gom9000/diode-tester/resources/ltspice-plot-1mA-thermal-drift.png

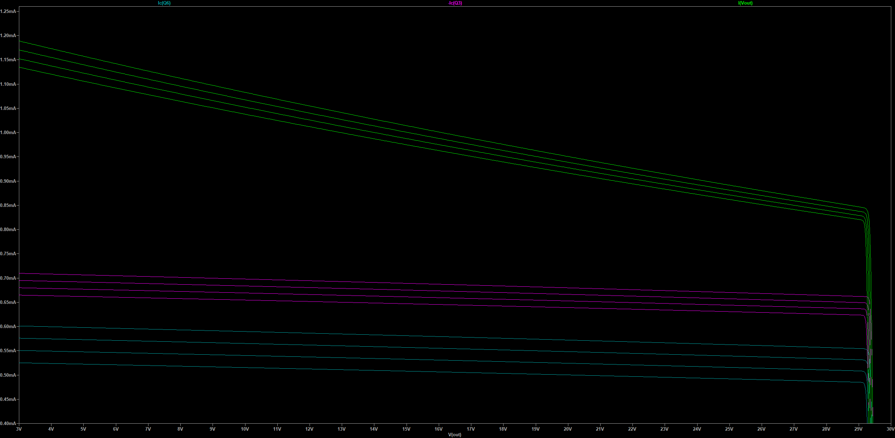
resources/ltspice-plot-1mA-thermal-drift.png
