gom9000/diode-tester/resources/ltspice-plot-1mA.png

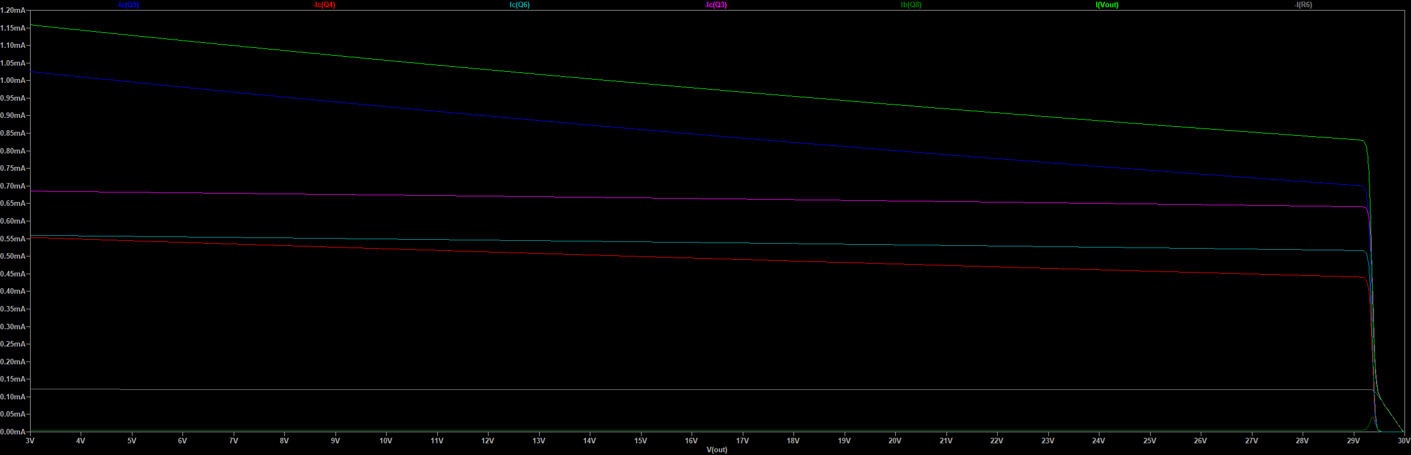
resources/ltspice-plot-1mA.png
