gom9000/diode-tester/resources/ltspice-plot-100mA-thermal-drift.png

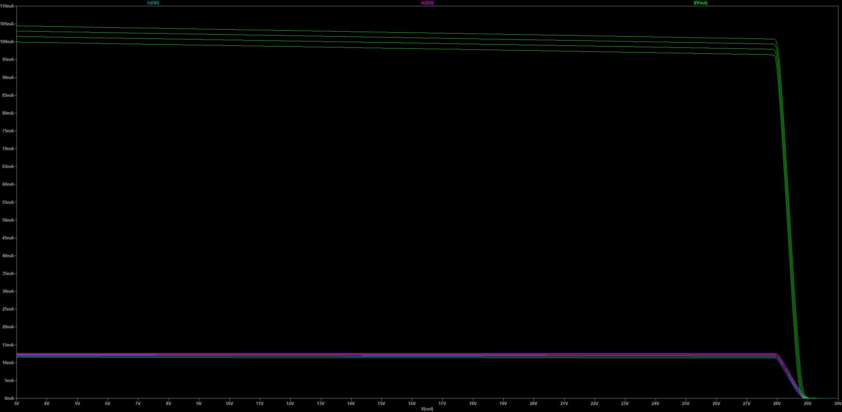
resources/ltspice-plot-100mA-thermal-drift.png
