gom9000/diode-tester/resources/ltspice-plot-100mA.png

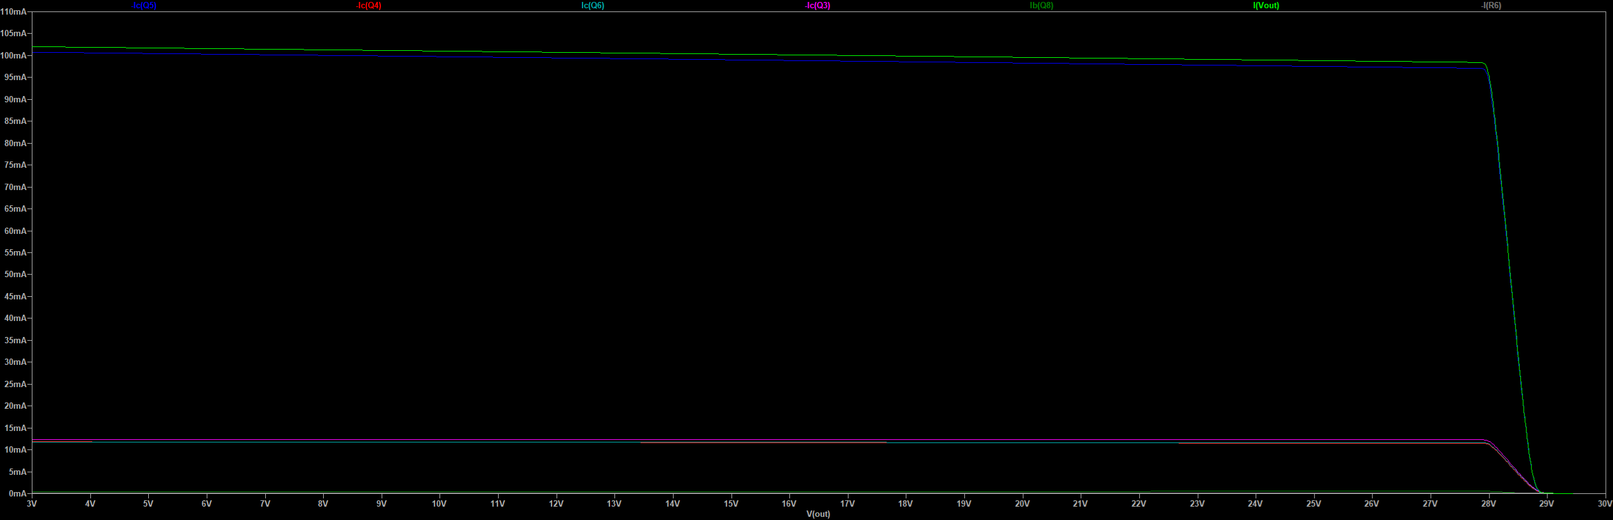
resources/ltspice-plot-100mA.png
