gom9000/diode-tester/resources/ltspice-schematic.png

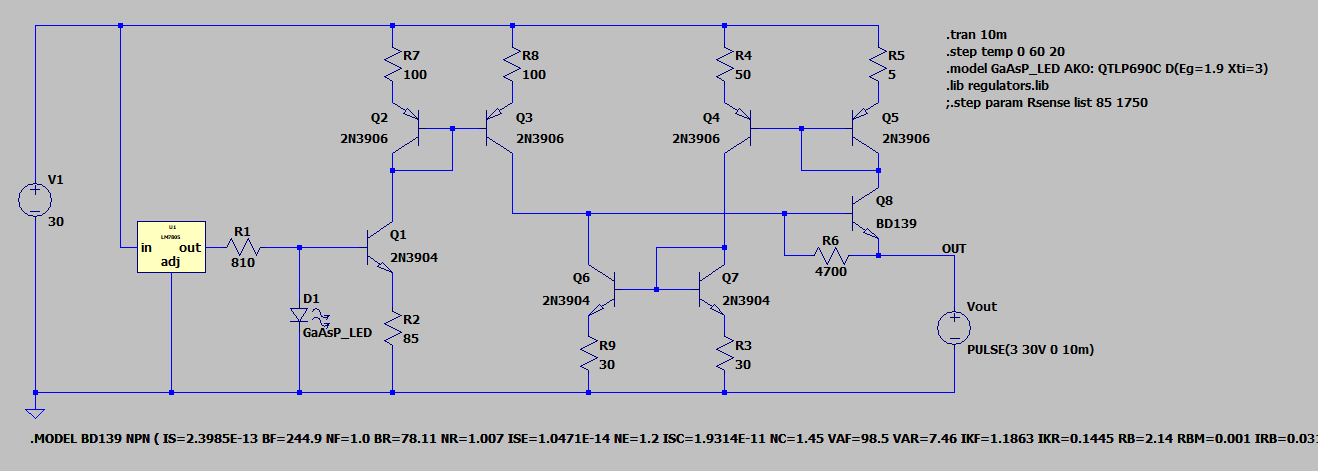
resources/ltspice-schematic.png
