gom9000/diode-tester/ltspice/diode-tester.asc

D1: LED; GaAsP_LED
Q1: NPN; 2N3904
Q2: pnp; 2N3906
Q3: pnp; 2N3906
Q4: pnp; 2N3906
Q5: pnp; 2N3906
Q6: NPN; 2N3904
Q7: NPN; 2N3904
Q8: NPN; BD139
R1: res; 810
R2: res; 85
R3: res; 30
R4: res; 50
R5: res; 5
R6: res; 4700
R7: res; 100
R8: res; 100
R9: res; 30
U1: reg3all
V1: voltage; 30
Vout: voltage; PULSE(3 30V 0 10m)
Named nets: 0, OUT
.tran 10m
.step temp 0 60 20
.model GaAsP_LED AKO: QTLP690C D(Eg=1.9 Xti=3)
.lib regulators.lib
;.step param Rsense list 85 1750
.MODEL BD139 NPN ( IS=2.3985E-13 BF=244.9 NF=1.0 BR=78.11 NR=1.007 ISE=1.0471E-14 NE=1.2 ISC=1.9314E-11 NC=1.45 VAF=98.5 VAR=7.46 IKF=1.1863 IKR=0.1445 RB=2.14 RBM=0.001 IRB=0.031 RE=0.0832 RC=0.01 CJE=2.92702E-10 VJE=0.67412 MJE=0.3300 FC=0.5 CJC=4.8831E-11 VJC=0.5258 MJC=0.3928 XCJC=0.5287 XTB=1.1398 EG=1.2105 XTI=3.0 Vceo=80 Icrating=3 mfg=fairchild)
