gom9000/diode-tester/pspice/bjt-constant-current-generator.asc

D1: diode; 1N4007
D2: diode; 1N4007
D3: diode; 1N4007
Q1: pnp; 2N3906
Q2: npn; 2N3904
Q3: npn; BD537
R1: res; 12K
R2: res; 51
R3: res; 14
V1: voltage; 24
Named nets: 0, Vb1, Vcc, Vc3, Ve3, Vc2, Vc1
.tran 10 startup
.lib C:\\MYA\\mya.alex.personal.electronics\\libraries\\ltspice-goslib\\customlib\\1N400x.lib
.model BD537    NPN(Is=974.4f Xti=3 Eg=1.11 Vaf=100 Bf=15 Ise=4.426n
+                               Ne=2.369 Ikf=.224 Nk=.4724 Xtb=1.5 Br=13.84 Isc=989.4f Nc=1.981
+                               Ikr=.3968 Rc=.1102 Cjc=214.4p Mjc=.3333 Vjc=.5 Fc=.5 Cje=643.2p
+                               Mje=.3333 Vje=.5 Tr=138.3n Tf=12.08n Itf=13.16 Xtf=1.445 Vtf=10)
