gom9000/diode-tester/(list of files, drawings)

Other design files:
hardware/diode-tester.pcb
