gom9000/diode-tester/resources/diode-tester_sch.png

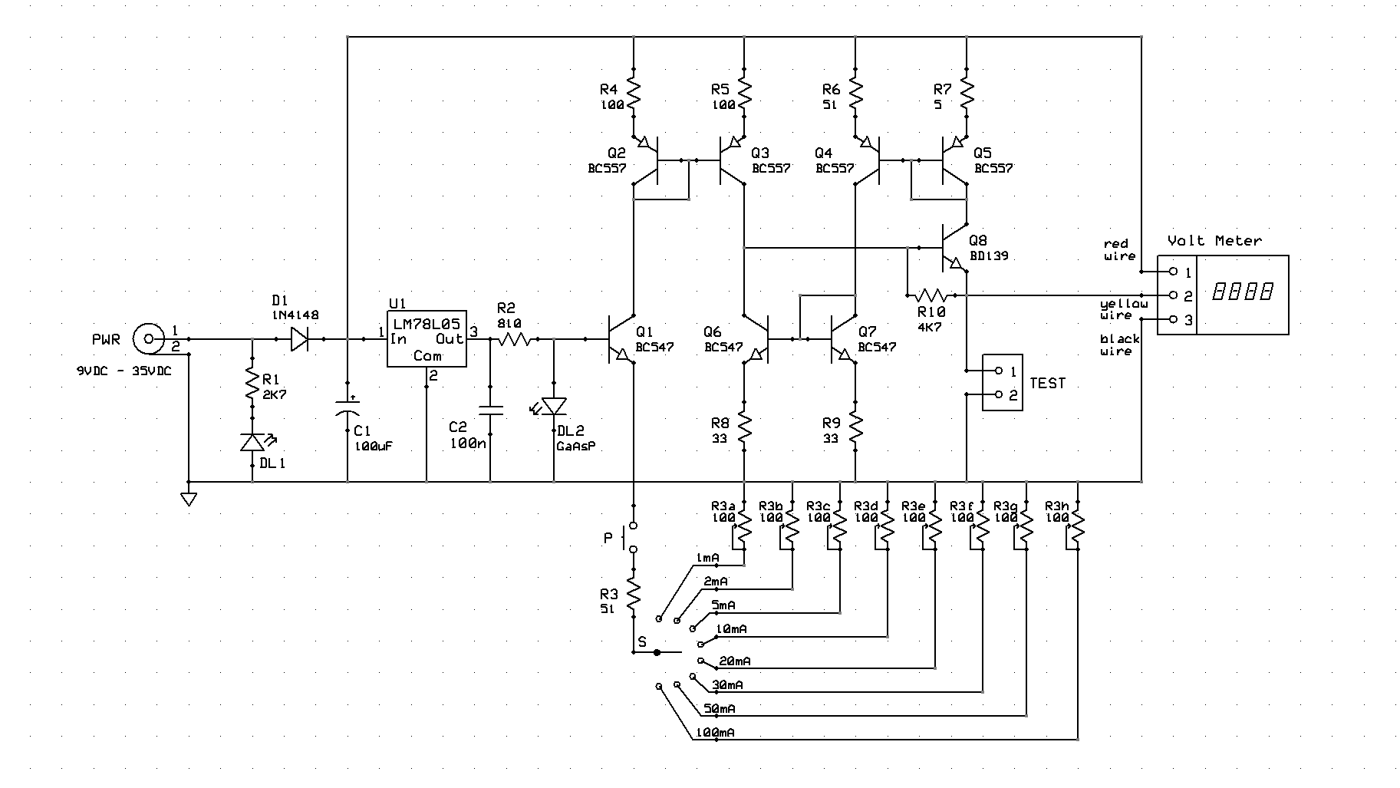
resources/diode-tester_sch.png
