gom9000/diode-tester/CHANGES.md

# CHANGES
This file contains the log of changes of **diode-tester** project.

## 0.2 Refactored hardware topology to keep the load referred to ground
- Updated hardware schematic
- Updated LTspice simulation

## 0.1
- Added hardware schematic
- Added LTspice simulation
- Added circuit analysis
- Added hardware pcb layout
- Added calibration procedure
