gom9000/diode-tester/TODO.md

# TODO
This file contains the todo list of **diode-tester** project.

## Next Tasks

### 1.0 "*mercury*" nnnn-nn-nn Feature release
- [ ] Make physical board

### 0.2 Refactory hardware topology to keep the load referred to ground
- [x] Refactory hardware schematic
- [x] Update LTspice simulation
- [ ] Update circuit analysis
- [ ] Update hardware pcb layout
- [ ] Update calibration procedure
- [ ] Add test log

### 0.1
- [x] Add hardware schematic
- [x] Add LTspice simulation
- [x] Add circuit analysis
- [x] Add hardware pcb layout
- [x] Add calibration procedure

## Future Tasks
