gom9000/diode-tester/(commit log)

2025-06-15 intial commit
    [diode-tester.pcb, diode-tester.sch]
2025-06-15 add polarity protection and circuit calculations
    [diode-tester.sch]
2025-06-15 add circuit calculations
2025-06-21 replace Q3 (darlington), change R2 (100), update schematic and simulation
    [diode-tester.sch]
2025-06-21 update schematic (show circuit functional blocks)
2025-06-21 update README descriptions
    [diode-tester.sch]
2025-06-22 add pcb layout and image
    [diode-tester.pcb]
2026-04-25 fix shifting voltage to zero ref for display
    [diode-tester.sch]
2026-05-03 update schematic and readme to manage load current selection and vol-meter only
    [diode-tester.sch]
2026-05-03 fix trimmer values
    [diode-tester.sch]
2026-05-03 fix sw1 trimmers
    [diode-tester.sch]
2026-05-03 update pcb
    [diode-tester.pcb]
2026-05-03 update OA
    [diode-tester.sch]
2026-05-07 resized pcb layout
    [diode-tester.pcb, diode-tester.sch]
2026-05-07 changed TL081 with LM358
    [diode-tester.sch]
2026-05-07 fix README
    [diode-tester.pcb]
2026-05-07 refactory pcb layout
    [diode-tester.pcb]
2026-06-02 refactory hardware schematic and update LTspice simulation
    [diode-tester.sch]
2026-06-02 add NO switch (P) on hardware schematic
    [diode-tester.sch]
